KHaririNL/VNT15Ecu/images/820C is max - Set to 500C.png

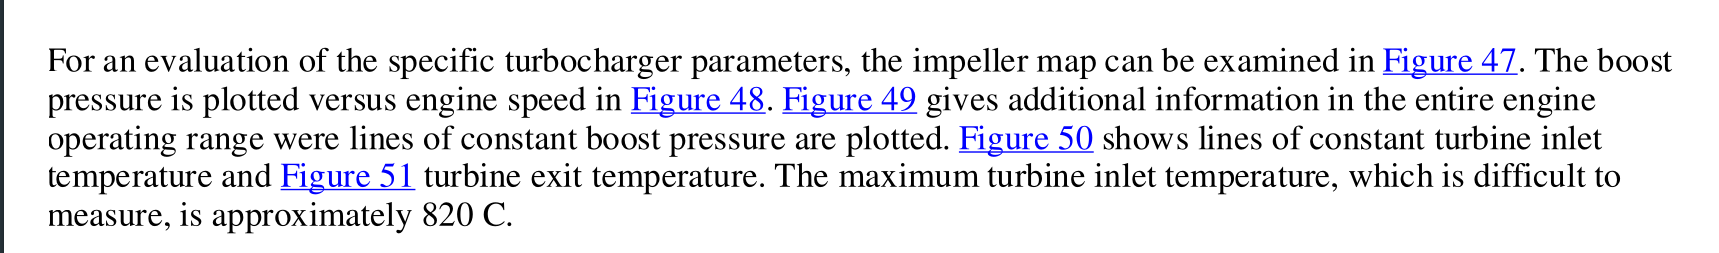
images/820C is max - Set to 500C.png
