KHaririNL/VNT15Ecu/images/Oil cooler only 30C.png

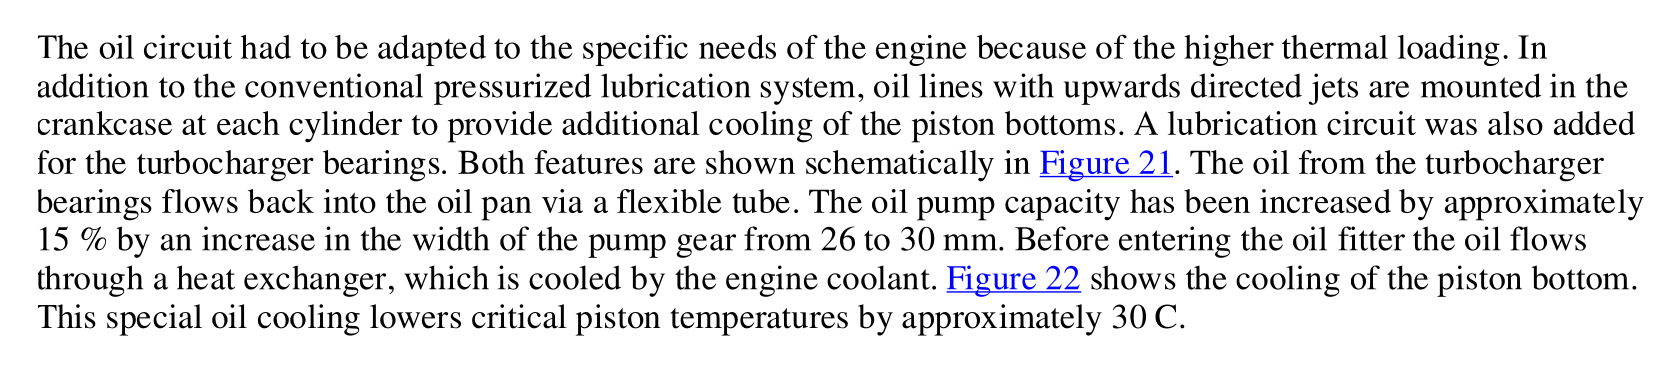
images/Oil cooler only 30C.png
