KHaririNL/VNT15Ecu/images/Valve Max temp.png

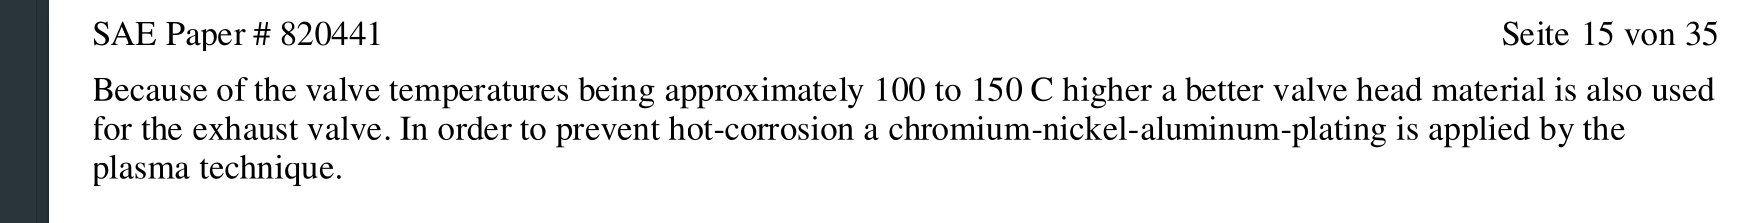
images/Valve Max temp.png
