KHaririNL/VNT15Ecu/(commit log)

2023-11-15 Update carputer.ino
    Major update, fixed frequency
    [carputer.ino]
2023-11-16 added driver circuit
